danielprint/Inkjet/RepRapPiezoInkjet/Documentation/Images/HeatedSetup.JPG

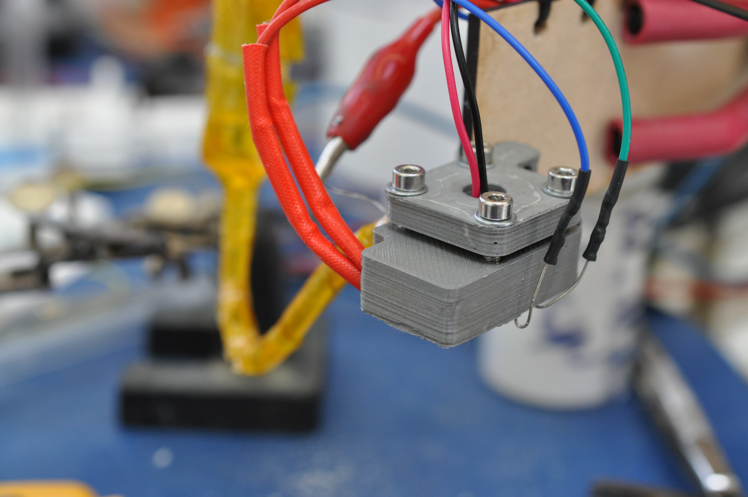
RepRapPiezoInkjet/Documentation/Images/HeatedSetup.JPG
