danielprint/Inkjet/RepRapPiezoInkjet/Documentation/Images/Assembly/DSC_4384.JPG

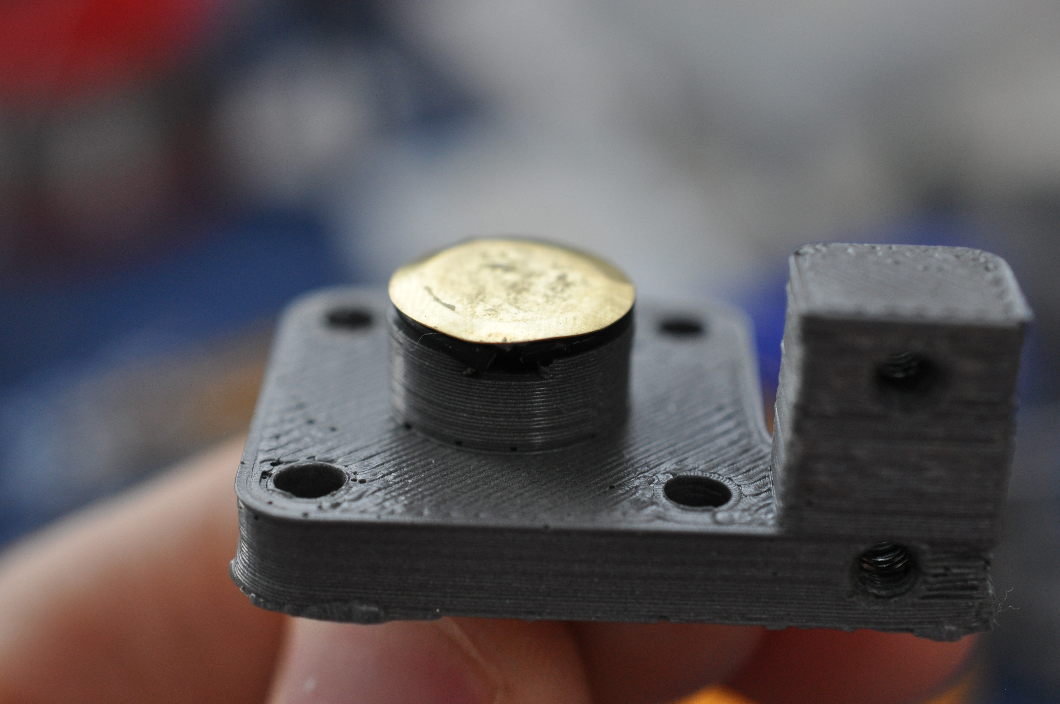
RepRapPiezoInkjet/Documentation/Images/Assembly/DSC_4384.JPG
