danielprint/Inkjet/AB-design/inkjet.png

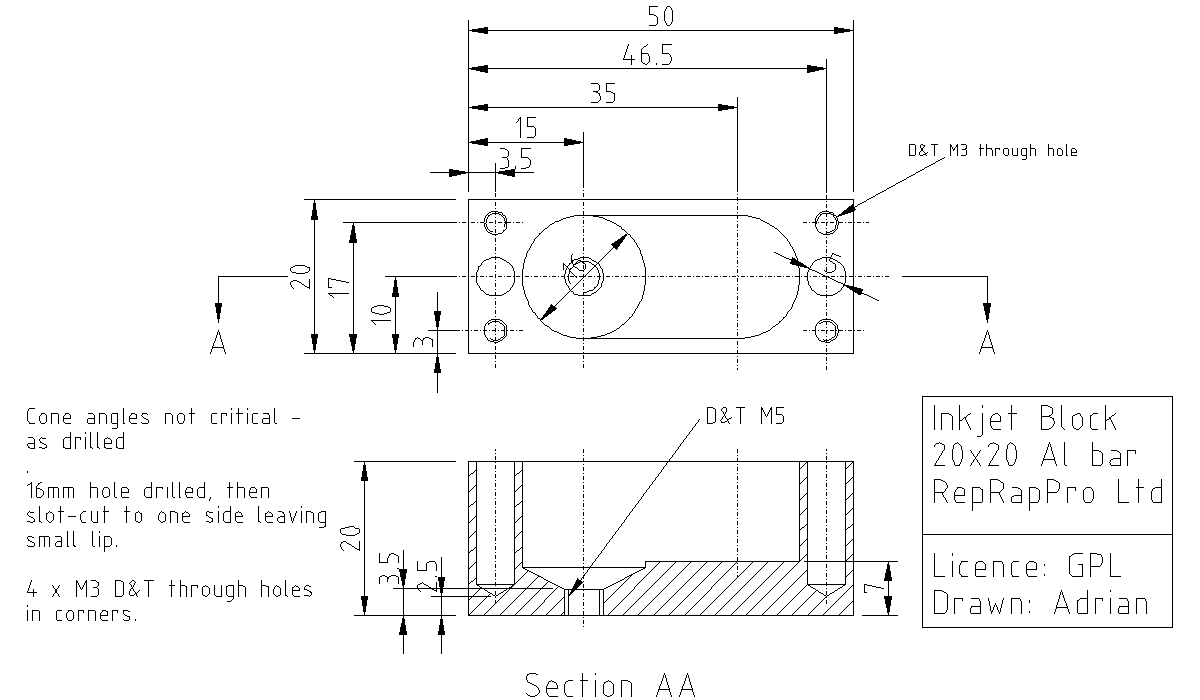
AB-design/inkjet.png
