danielprint/Inkjet/HP51604_Inkjet/Documentation/InkjetPinNumbering.png

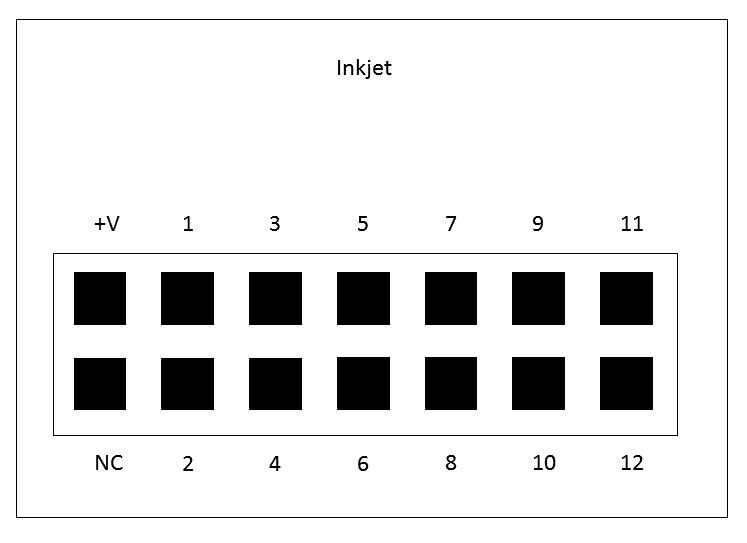
HP51604_Inkjet/Documentation/InkjetPinNumbering.png
