danielprint/Inkjet/HP51604A/InkjetHolder/section.png

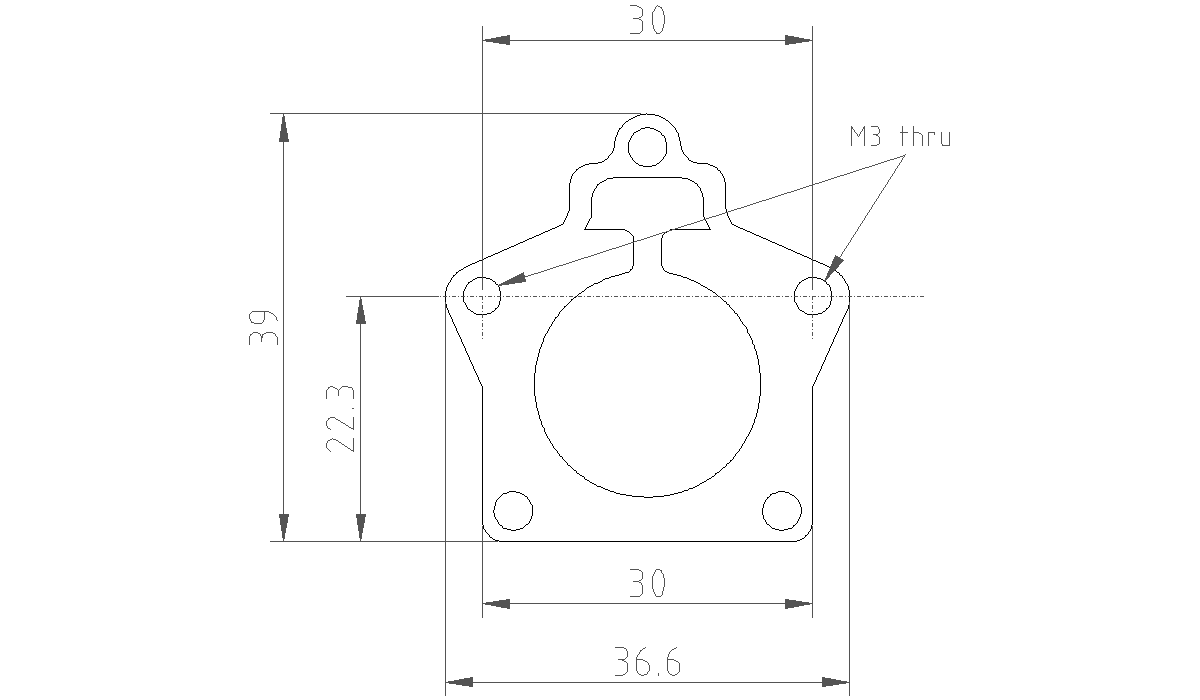
HP51604A/InkjetHolder/section.png
