danielprint/Inkjet/RepRapPiezoInkjet/Documentation/Images/JetCloseup.JPG

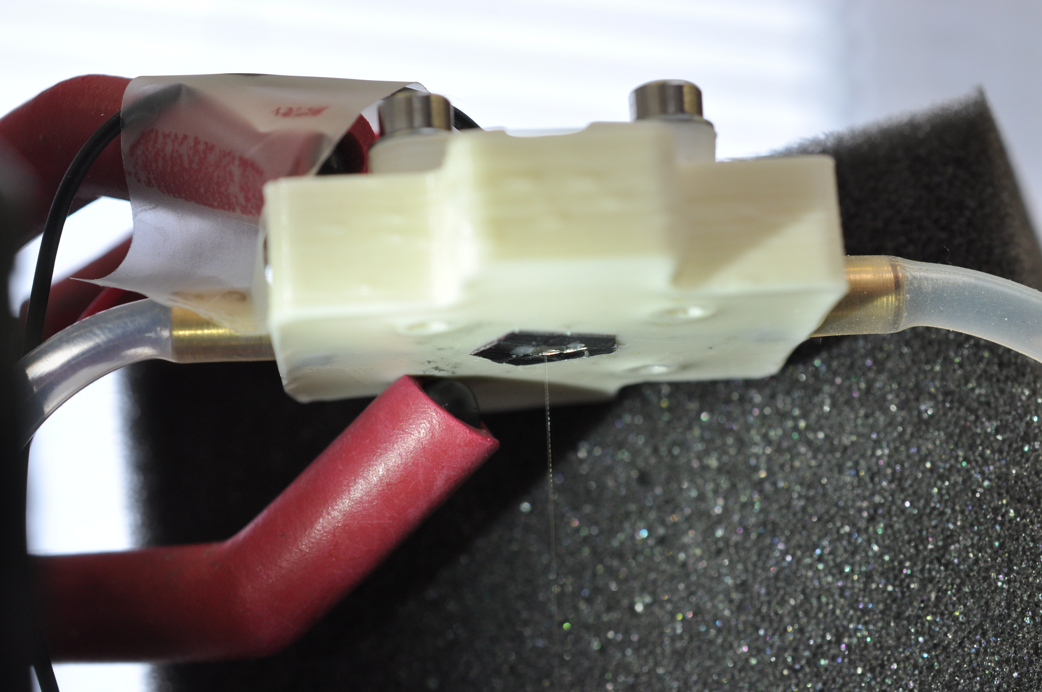
RepRapPiezoInkjet/Documentation/Images/JetCloseup.JPG
