danielprint/Inkjet/RepRapPiezoInkjet/Documentation/Images/MeshLaserCut.JPG

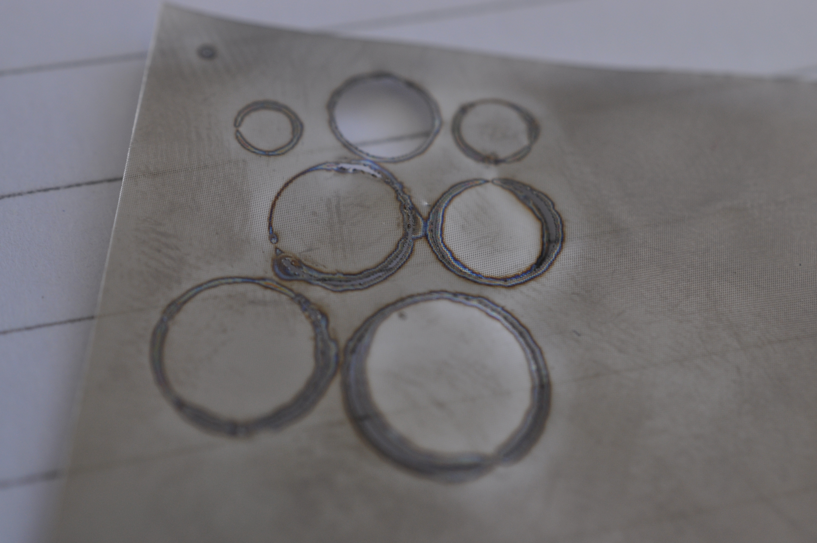
RepRapPiezoInkjet/Documentation/Images/MeshLaserCut.JPG
