danielprint/Inkjet/RepRapPiezoInkjet/Documentation/Images/MountedOnMachine.JPG

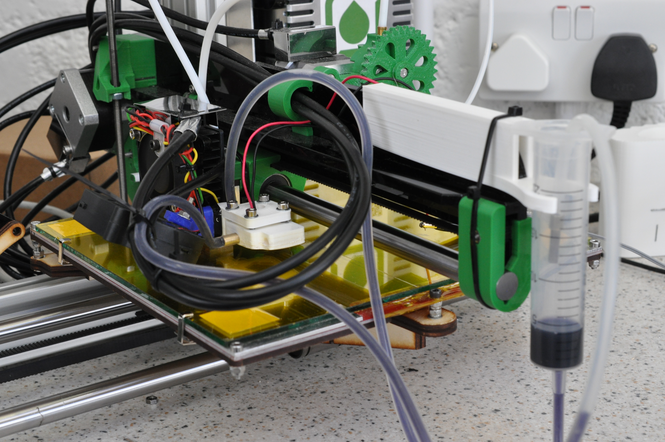
RepRapPiezoInkjet/Documentation/Images/MountedOnMachine.JPG
