danielprint/Inkjet/RepRapPiezoInkjet/Documentation/Images/NozzleCloseUp.JPG

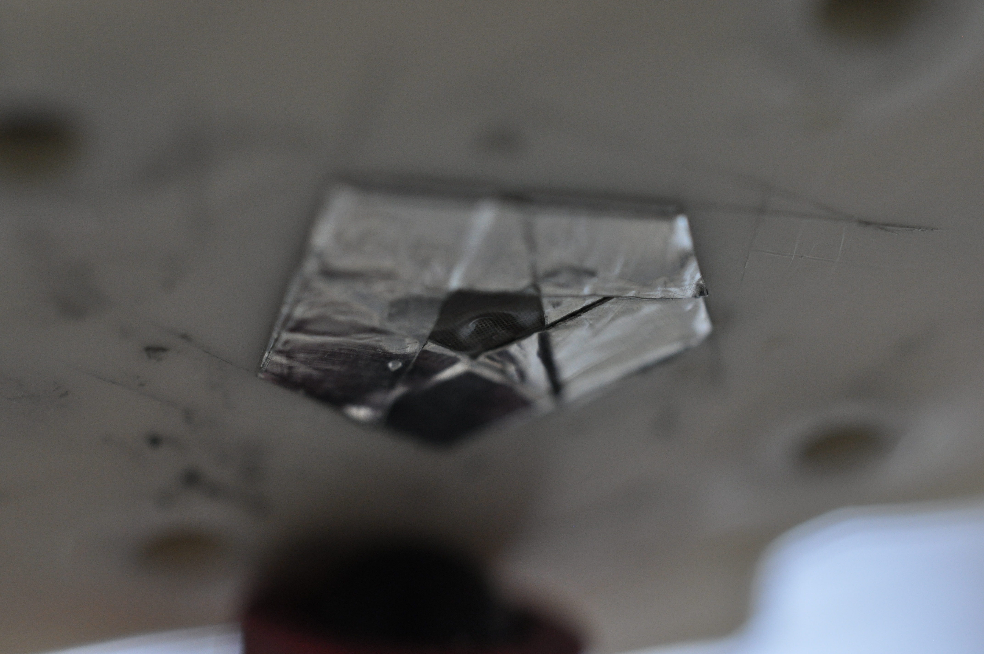
RepRapPiezoInkjet/Documentation/Images/NozzleCloseUp.JPG
