danielprint/Inkjet/HP51604_Inkjet/Documentation/BOM_mount+PCB.ods

Part Name | Qty | Type
Mount – Lower – Generic Mount | 1 | Printed Part
Mount – Upper – Generic Mount | 1 | Printed Part
Cable Tidy | 1 | Printed Part
Breakout Circuit Board | 1 | Circuit Board – Assembled
M3x12 Cap Head Machine Screw | 1 | Fastener
M3x20 Cap Head Machine Screw | 2 | Fastener
HP51604A Inkjet Cartridge | 1 | Ink cartridge
