danielprint/Inkjet/AB-design/FreeCAD/InkjetHolderHorizontalMount.fcstd

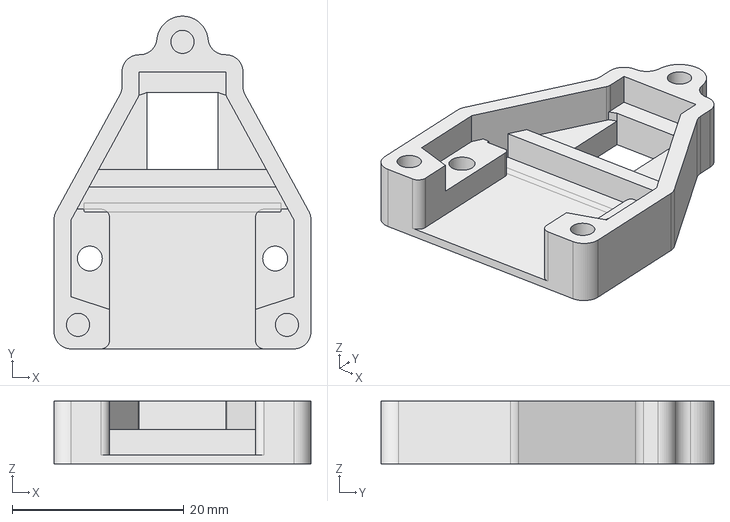
[picture p15: CAD file, 2015-09-08]
AB-design/FreeCAD/InkjetHolderHorizontalMount.fcstd
29.9 x 38.8 x 7.30 mm
