danielprint/Inkjet/AB-design/insert.stl

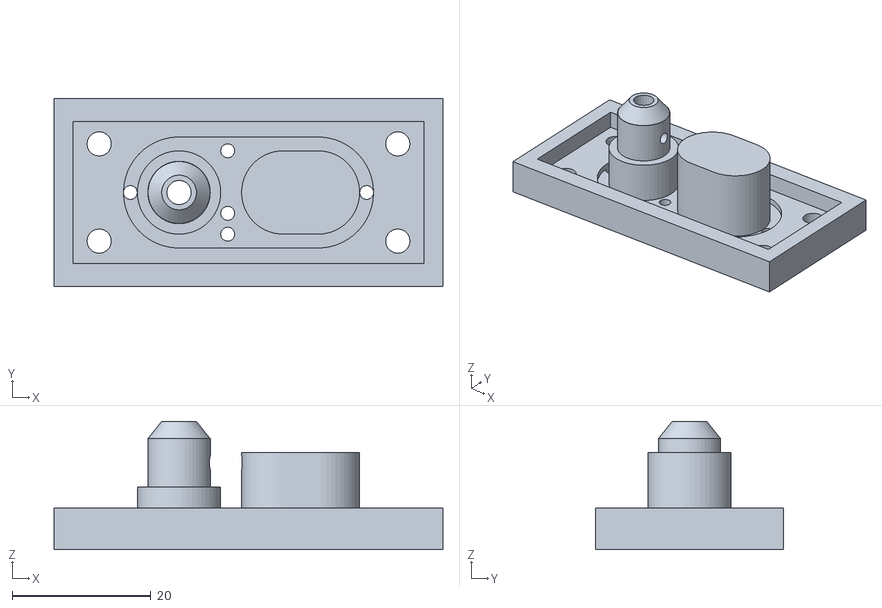
[picture p16: CAD file, 2015-09-04]
AB-design/insert.stl
56.0 x 27.0 x 18.4
