danielprint/Inkjet/HP51604_Inkjet/CircuitBoards/InkjetBreakoutPCB/InkjetBreakout-F_Cu.dxf

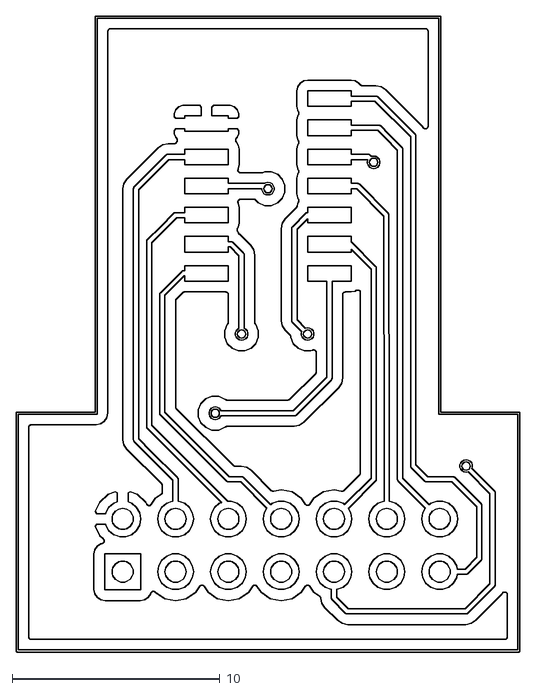
[picture p17: CAD file, 2015-09-04]
HP51604_Inkjet/CircuitBoards/InkjetBreakoutPCB/InkjetBreakout-F_Cu.dxf
24.2 x 30.6
