danielprint/Inkjet/HP51604_Inkjet/CircuitBoards/InkjetDriverPCB/Gerbers/InkjetDriver-F_Cu.dxf

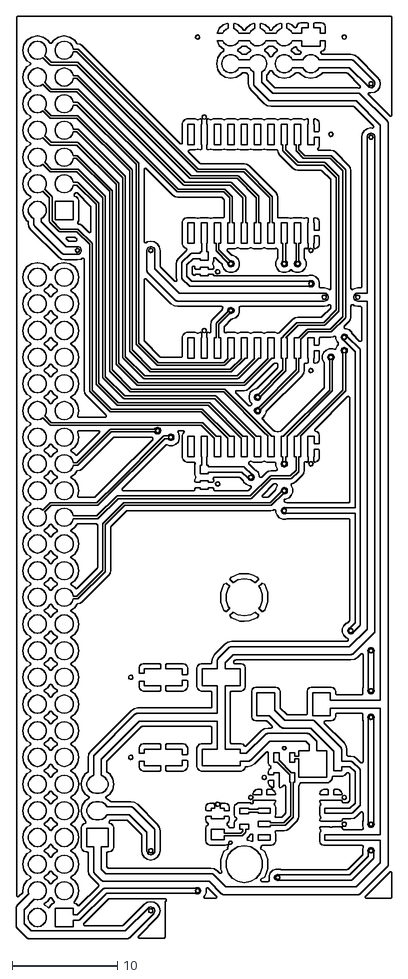
[picture p18: CAD file, 2015-09-04]
HP51604_Inkjet/CircuitBoards/InkjetDriverPCB/Gerbers/InkjetDriver-F_Cu.dxf
35.8 x 87.8
