danielprint/Inkjet/HP51604_Inkjet/Printed_Parts/CartridgeOnlyKit/STEP/UpperHorizontalMount.stp

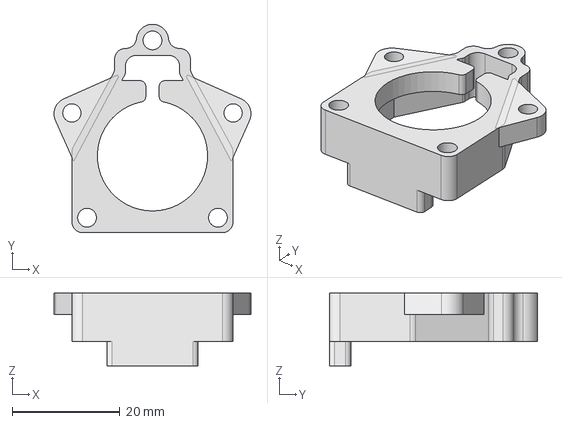
[picture p19: CAD file, 2015-09-04]
HP51604_Inkjet/Printed_Parts/CartridgeOnlyKit/STEP/UpperHorizontalMount.stp
36.6 x 38.8 x 13.5 mm
