danielprint/Inkjet/HP51604_Inkjet/Printed_Parts/FullOrmerodKit/STEP/UpperOrmerodMount.stp

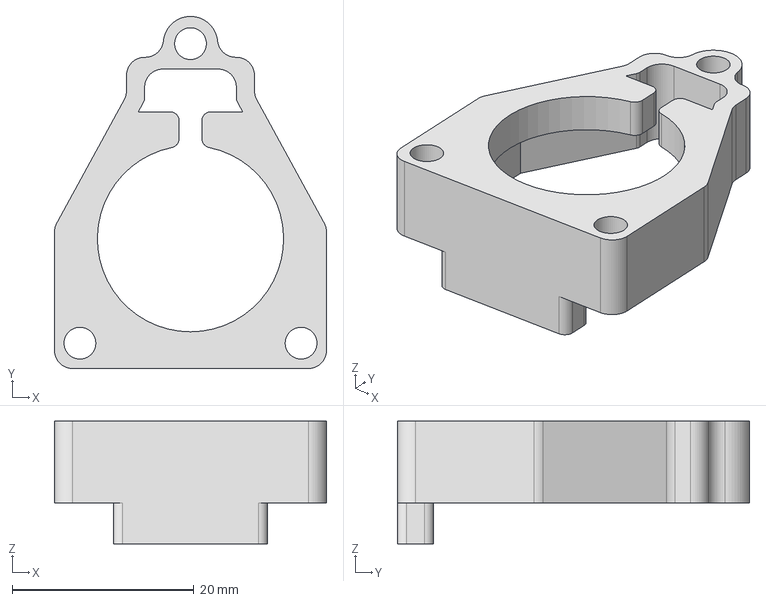
[picture p20: CAD file, 2015-09-04]
HP51604_Inkjet/Printed_Parts/FullOrmerodKit/STEP/UpperOrmerodMount.stp
29.9 x 38.8 x 13.5 mm
