danielprint/Inkjet/HP51604A/InkjetHolder/section.dxf

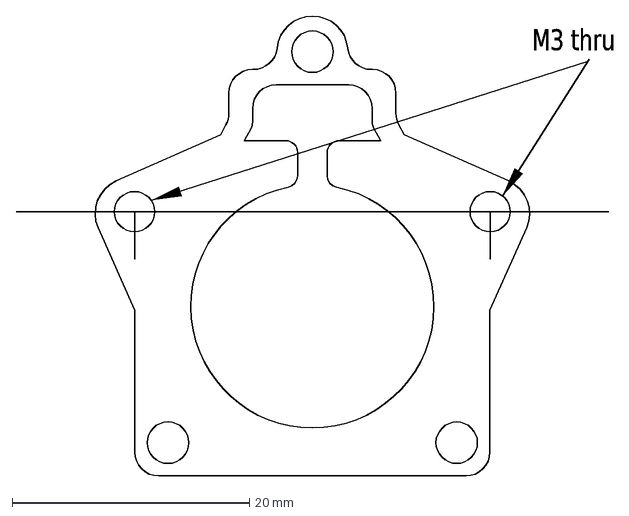
[picture p21: CAD file, 2015-09-08]
HP51604A/InkjetHolder/section.dxf
M3 thru
