danielprint/Inkjet/HP51604A/outline.dxf

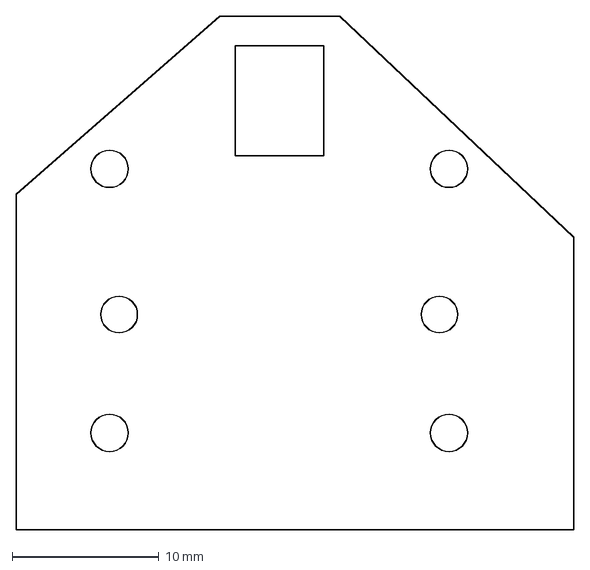
[picture p22: CAD file, 2014-11-24]
HP51604A/outline.dxf
38.0 x 35.0 mm
