danielprint/Inkjet/RepRapPiezoInkjet/12mmInkjet/STEP/Body.stp

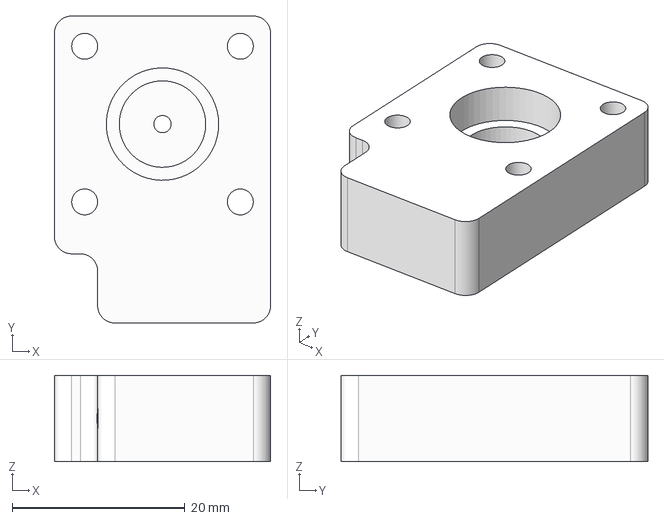
[picture p23: CAD file, 2015-09-04]
RepRapPiezoInkjet/12mmInkjet/STEP/Body.stp
25.0 x 35.5 x 10.0 mm
