danielprint/Inkjet/RepRapPiezoInkjet/12mmInkjet/STL/Top_Genertic.stl

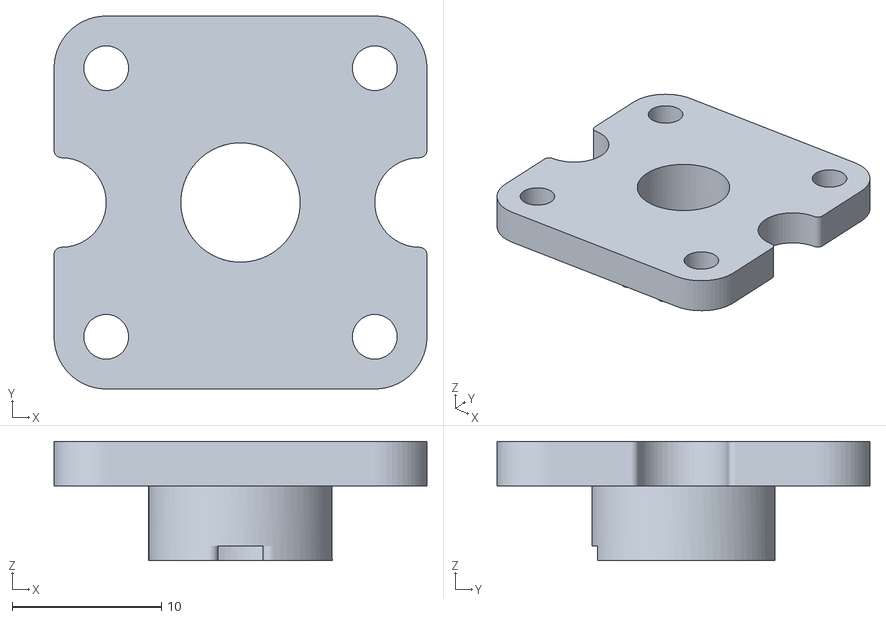
[picture p24: CAD file, 2015-09-04]
RepRapPiezoInkjet/12mmInkjet/STL/Top_Genertic.stl
25.0 x 25.0 x 8.00
