danielprint/Inkjet/AB-design/inkjet.dxf

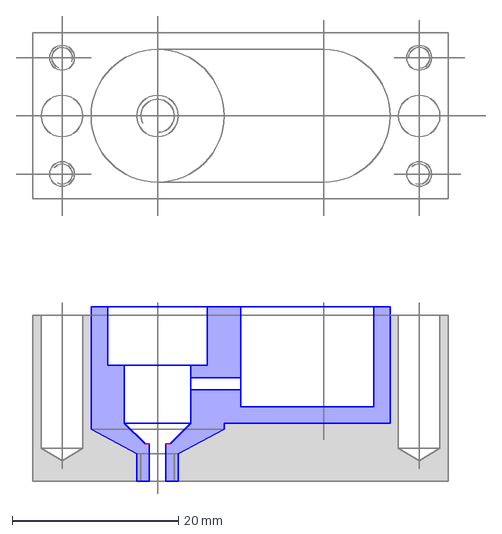
[picture p25: CAD file, 2015-09-04]
AB-design/inkjet.dxf
56.5 x 57.5 mm
