danielprint/Inkjet/HP51604_Inkjet/Printed_Parts/CartridgeOnlyKit/STEP/CableTidy.stp

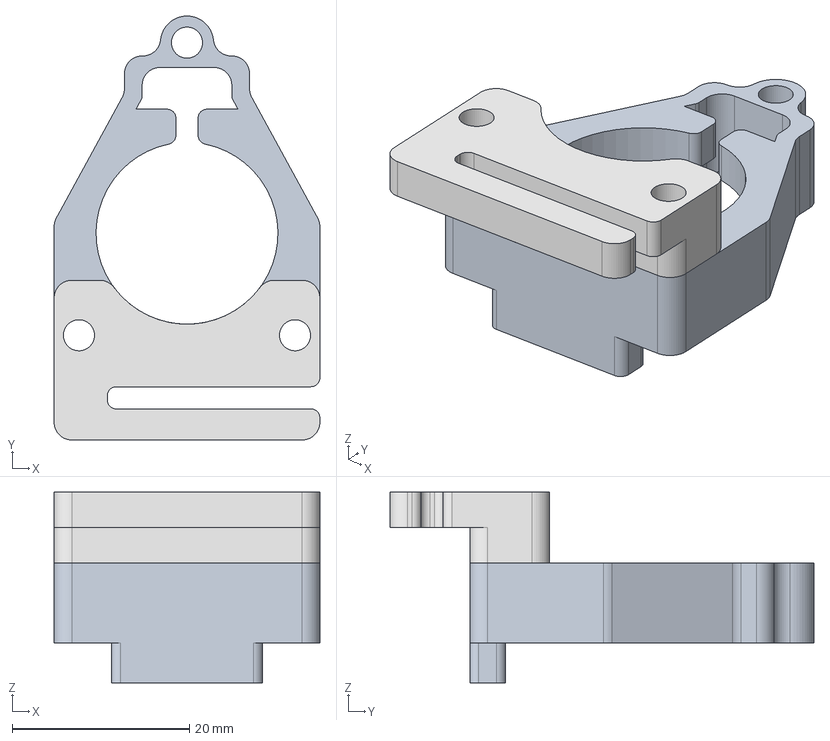
[picture p26: CAD file, 2015-09-04]
HP51604_Inkjet/Printed_Parts/CartridgeOnlyKit/STEP/CableTidy.stp
29.9 x 47.8 x 21.5 mm
