danielprint/Inkjet/HP51604_Inkjet/Printed_Parts/FullOrmerodKit/STEP/BottomOrmerodMount.stp

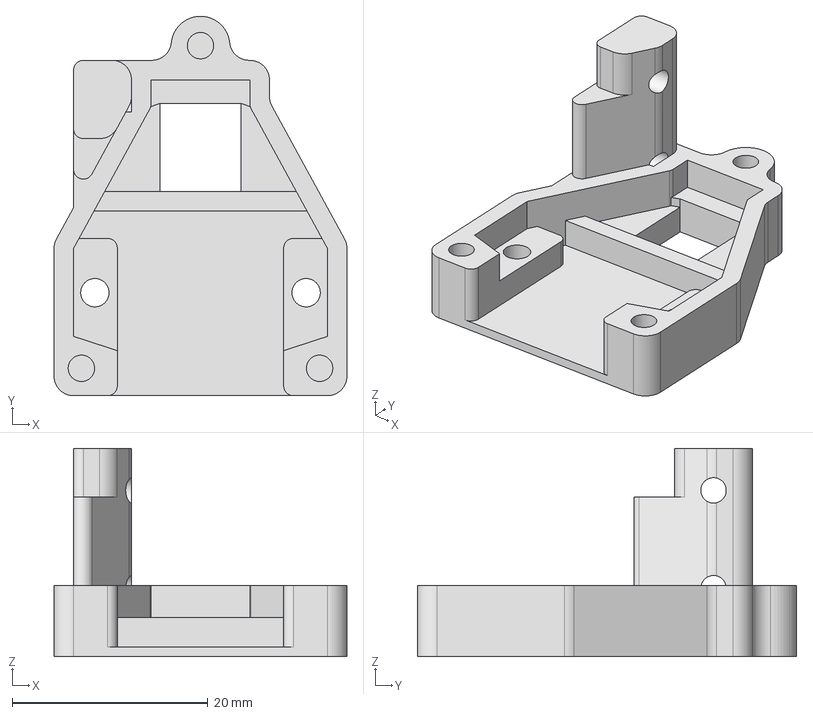
[picture p27: CAD file, 2015-09-04]
HP51604_Inkjet/Printed_Parts/FullOrmerodKit/STEP/BottomOrmerodMount.stp
29.9 x 38.8 x 21.3 mm
