danielprint/Inkjet/HP51604A/chans-outline.dxf

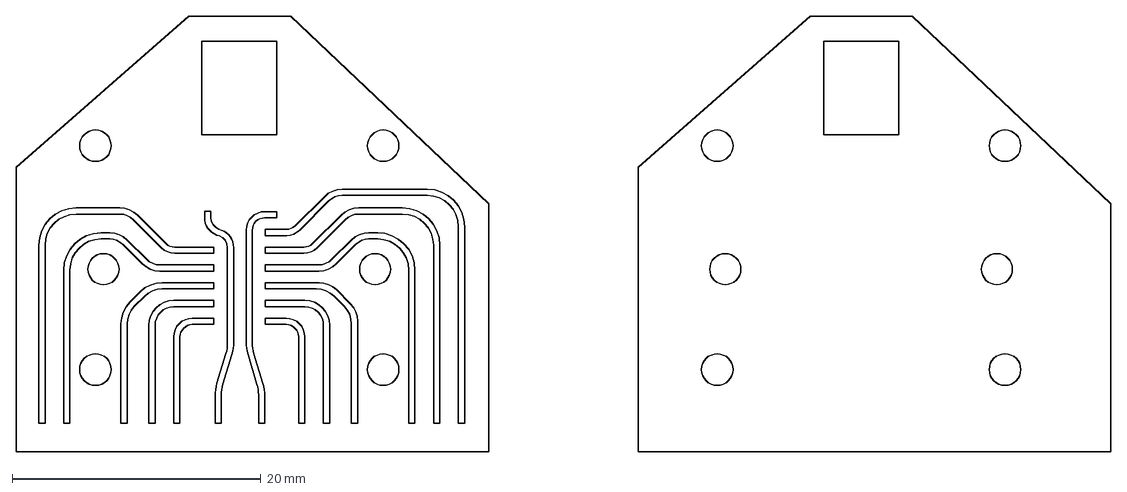
[picture p28: CAD file, 2014-11-24]
HP51604A/chans-outline.dxf
88.0 x 35.0 mm
