danielprint/Inkjet/RepRapPiezoInkjet/12mmInkjet/STEP/Top_OrmerodMount.stp

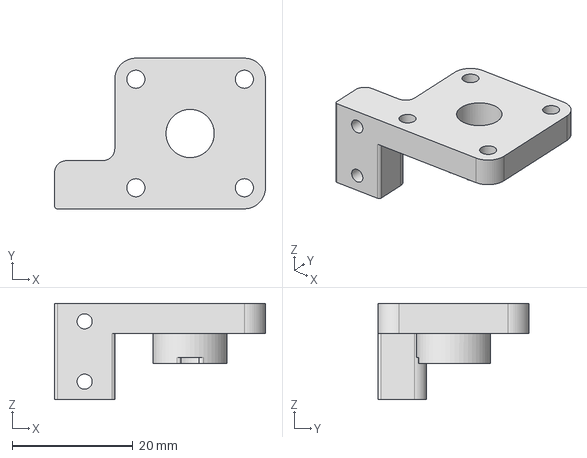
[picture p29: CAD file, 2015-09-04]
RepRapPiezoInkjet/12mmInkjet/STEP/Top_OrmerodMount.stp
35.0 x 25.0 x 16.0 mm
