danielprint/Inkjet/HP51604A/slots.dxf

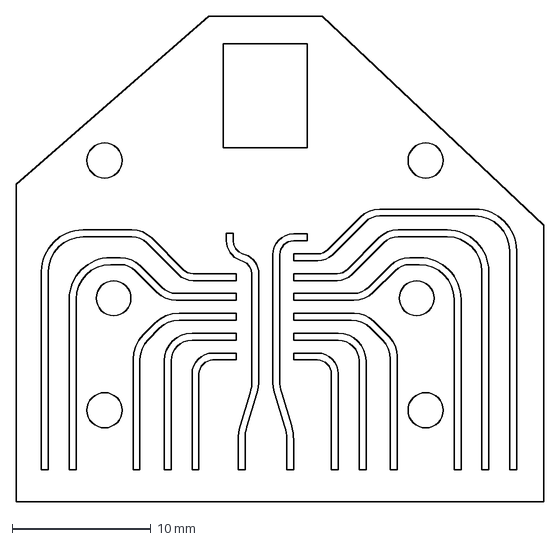
[picture p30: CAD file, 2014-11-24]
HP51604A/slots.dxf
38.0 x 35.0 mm
