danielprint/Inkjet/RepRapPiezoInkjet/12mmInkjet/STEP/SyringeReservoirOrmerodMount.stp

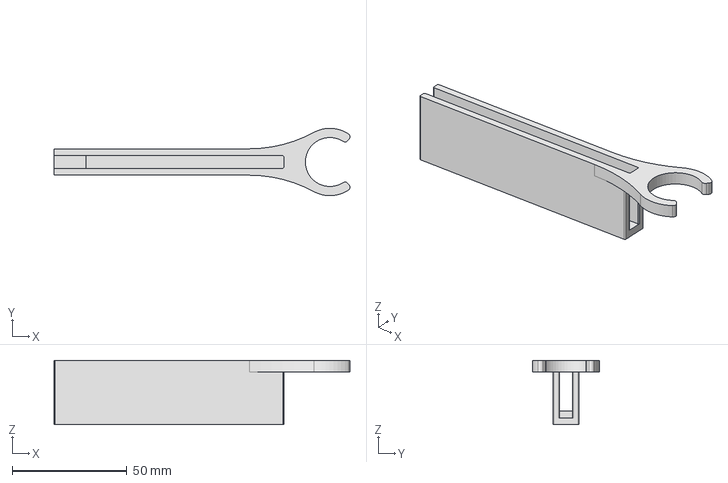
[picture p31: CAD file, 2015-09-04]
RepRapPiezoInkjet/12mmInkjet/STEP/SyringeReservoirOrmerodMount.stp
128.7 x 29.3 x 28.0 mm
