danielprint/Inkjet/HP51604A/test.dxf

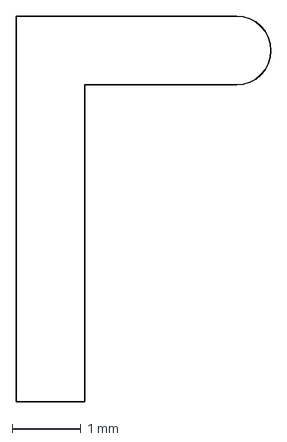
[picture p32: CAD file, 2014-09-24]
HP51604A/test.dxf
3.70 x 5.60 mm
