danielprint/Inkjet/HP51604A/just-slots.dxf

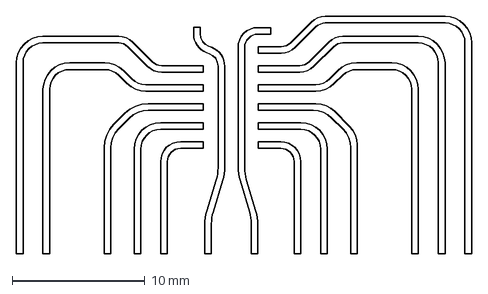
[picture p33: CAD file, 2014-09-24]
HP51604A/just-slots.dxf
34.2 x 17.9 mm
