danielprint/Inkjet/(list of files, cad)

Other CAD files:
HP51604_Inkjet/Other/HP51604A/InkjetHolder/InkjetHolderHorizontalMount.stp
AB-design/FreeCAD/UpperHorizontalMount.fcstd
HP51604_Inkjet/Other/HP51604A/InkjetHolder/InkjetHolderVerticalMount.stp
HP51604_Inkjet/Printed_Parts/CartridgeOnlyKit/STEP/InkjetHolderHorizontalMount.stp
HP51604_Inkjet/Other/HP51604A/InkjetHolder/UpperVerticalMount.stp
RepRapPiezoInkjet/12mmInkjet/STEP/Top_Generic.stp
HP51604_Inkjet/Other/HP51604A/InkjetHolder/CableTidy.stp
HP51604A/HP51604A.fcstd
HP51604_Inkjet/Other/HP51604A/InkjetHolder/CableTidy.stl
HP51604_Inkjet/Other/HP51604A/InkjetHolder/InkjetHolderHorizontalMount.fcstd
HP51604_Inkjet/Other/HP51604A/InkjetHolder/InkjetHolderHorizontalMount.stl
HP51604_Inkjet/Other/HP51604A/InkjetHolder/InkjetHolderVerticalMount.stl
HP51604_Inkjet/Other/HP51604A/InkjetHolder/UpperHorizontalMount.fcstd
HP51604_Inkjet/Other/HP51604A/InkjetHolder/UpperHorizontalMount.stl
HP51604_Inkjet/Other/HP51604A/InkjetHolder/UpperVerticalMount.stl
HP51604_Inkjet/Printed_Parts/CartridgeOnlyKit/STL/CableTidy.stl
HP51604_Inkjet/Printed_Parts/CartridgeOnlyKit/STL/InkjetHolderHorizontalMount.stl
HP51604_Inkjet/Printed_Parts/CartridgeOnlyKit/STL/UpperHorizontalMount.stl
HP51604_Inkjet/Printed_Parts/FullOrmerodKit/STL/BottomOrmerodMount.stl
HP51604_Inkjet/Printed_Parts/FullOrmerodKit/STL/CableTidy.stl
HP51604_Inkjet/Printed_Parts/FullOrmerodKit/STL/UpperOrmerodMount.stl
RepRapPiezoInkjet/12mmInkjet/STL/Body.stl
RepRapPiezoInkjet/12mmInkjet/STL/SyringeReservoirOrmerodMount.stl
RepRapPiezoInkjet/12mmInkjet/STL/Top_OrmerodMount.stl
