danielprint/Inkjet/RepRapPiezoInkjet/Documentation/Images/Assembly/DSC_4382.JPG

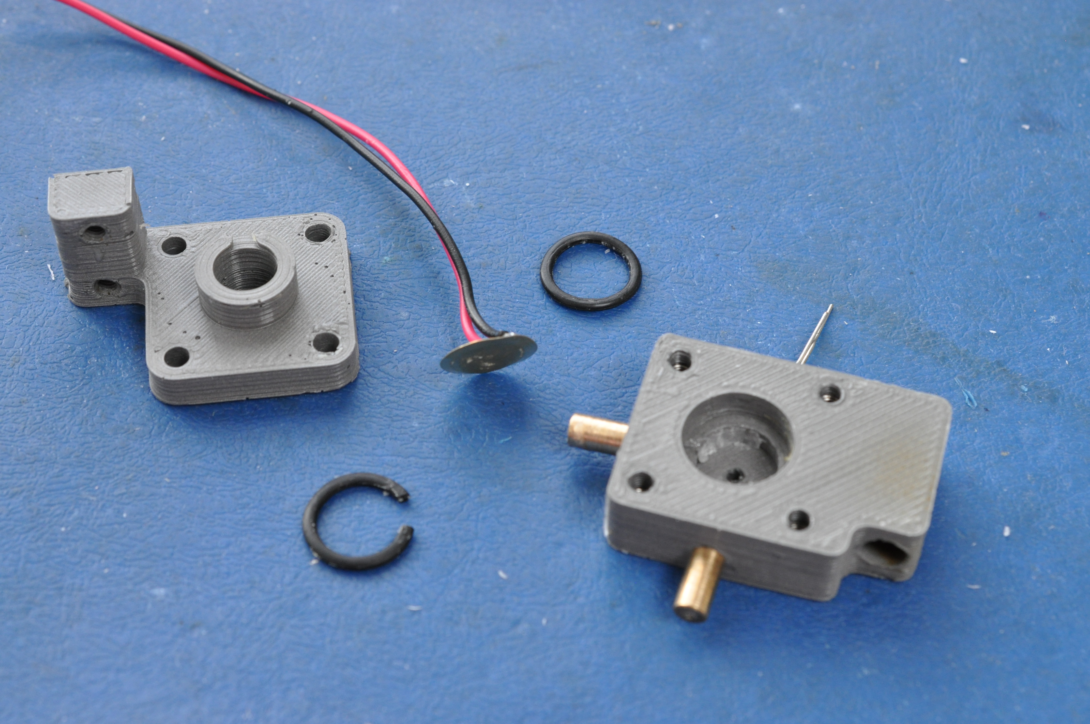
RepRapPiezoInkjet/Documentation/Images/Assembly/DSC_4382.JPG
