danielprint/Inkjet/RepRapPiezoInkjet/Documentation/Images/Assembly/DSC_4383.JPG

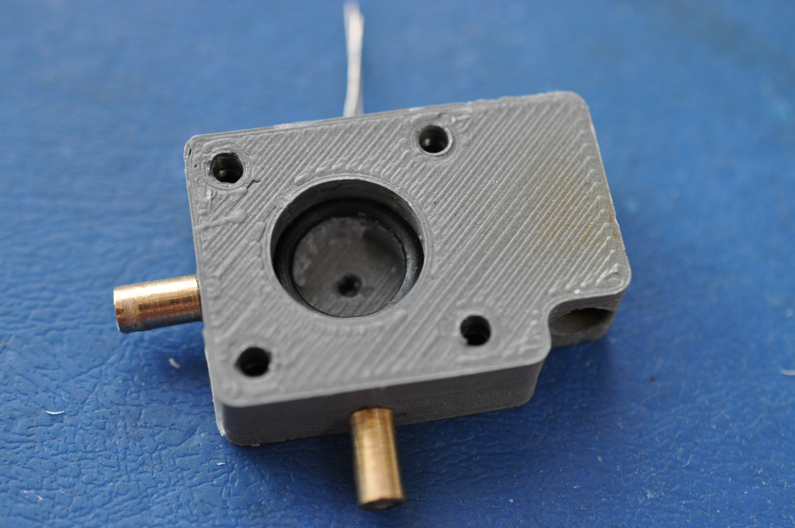
RepRapPiezoInkjet/Documentation/Images/Assembly/DSC_4383.JPG
