danielprint/Inkjet/RepRapPiezoInkjet/Documentation/Images/Assembly/DSC_4385.JPG

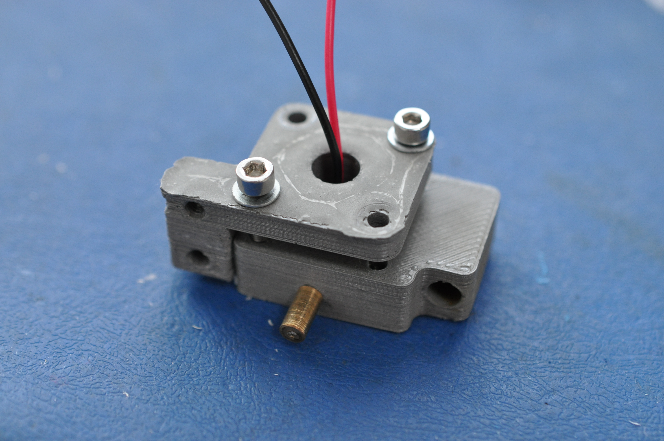
RepRapPiezoInkjet/Documentation/Images/Assembly/DSC_4385.JPG
