danielprint/Inkjet/RepRapPiezoInkjet/Documentation/Images/Assembly/DSC_4386.JPG

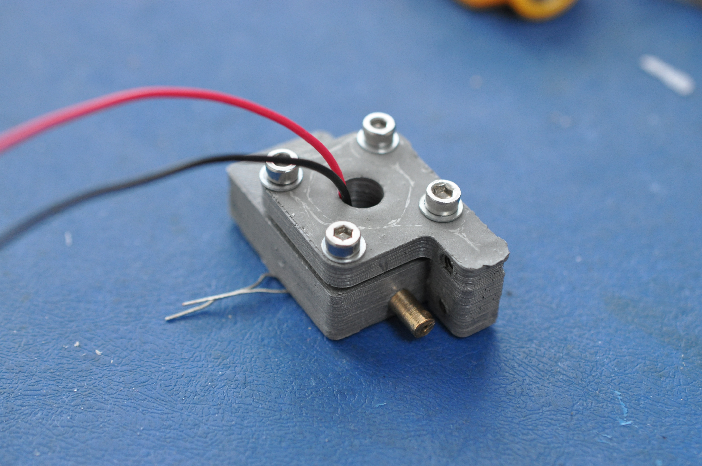
RepRapPiezoInkjet/Documentation/Images/Assembly/DSC_4386.JPG
