danielprint/Inkjet/RepRapPiezoInkjet/Documentation/Images/Assembly/DSC_4391.JPG

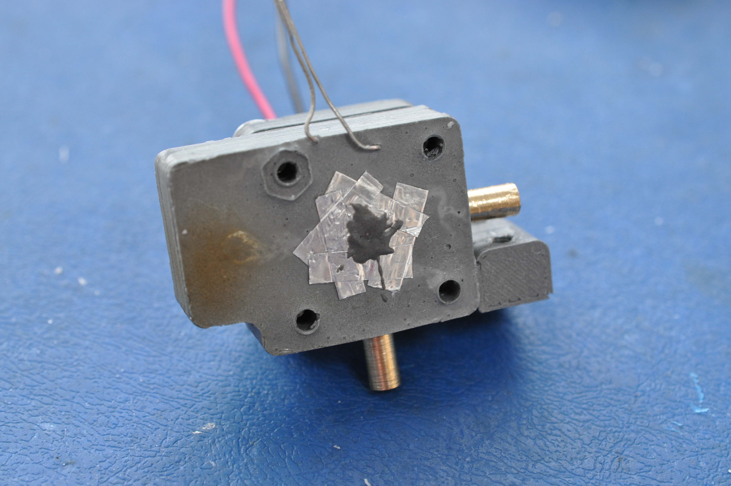
RepRapPiezoInkjet/Documentation/Images/Assembly/DSC_4391.JPG
