danielprint/Inkjet/RepRapPiezoInkjet/Documentation/Images/Assembly/DSC_4396.JPG

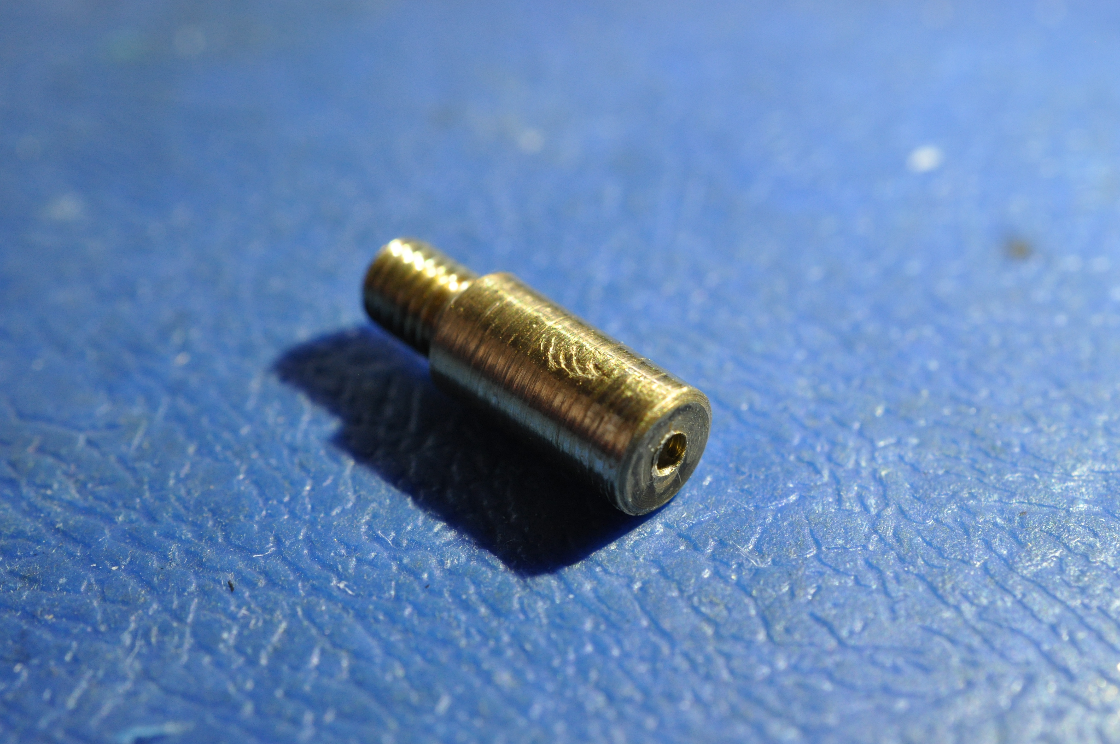
RepRapPiezoInkjet/Documentation/Images/Assembly/DSC_4396.JPG
