danielprint/Inkjet/RepRapPiezoInkjet/Documentation/Images/Assembly/DSC_4397.JPG

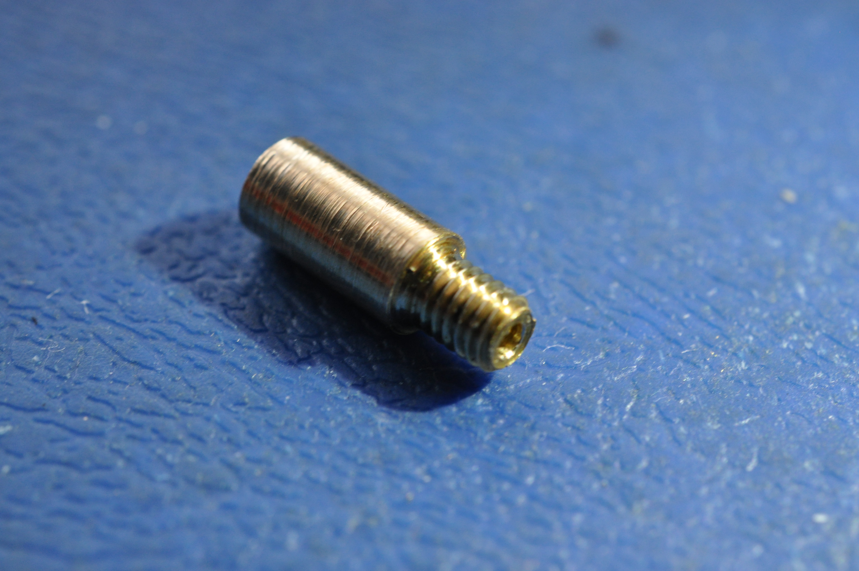
RepRapPiezoInkjet/Documentation/Images/Assembly/DSC_4397.JPG
