danielprint/Inkjet/RepRapPiezoInkjet/Documentation/Images/GeneralSetup.JPG

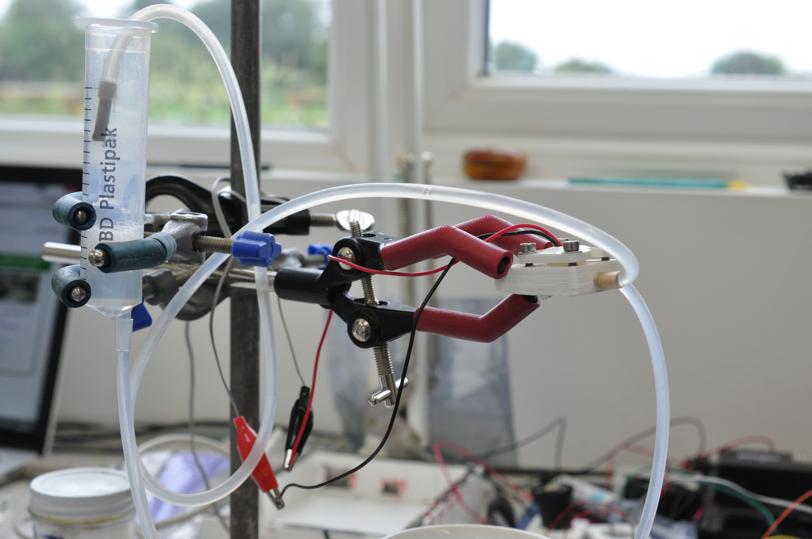
RepRapPiezoInkjet/Documentation/Images/GeneralSetup.JPG
