danielprint/Inkjet/RepRapPiezoInkjet/Documentation/Images/PrintedInkjetBottom.JPG

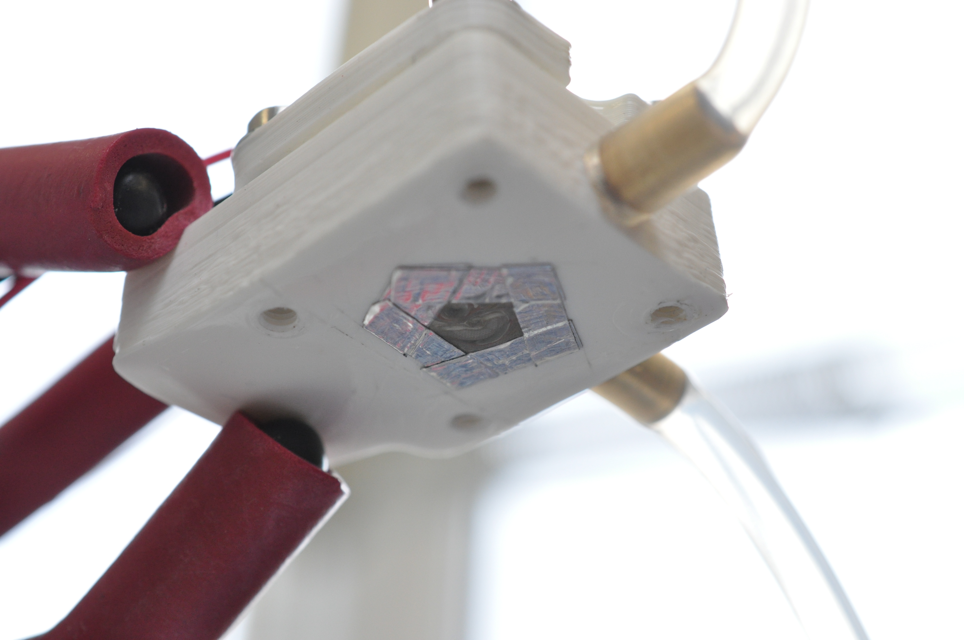
RepRapPiezoInkjet/Documentation/Images/PrintedInkjetBottom.JPG
