danielprint/Inkjet/RepRapPiezoInkjet/Documentation/Images/PrintedInkjetCloseup.JPG

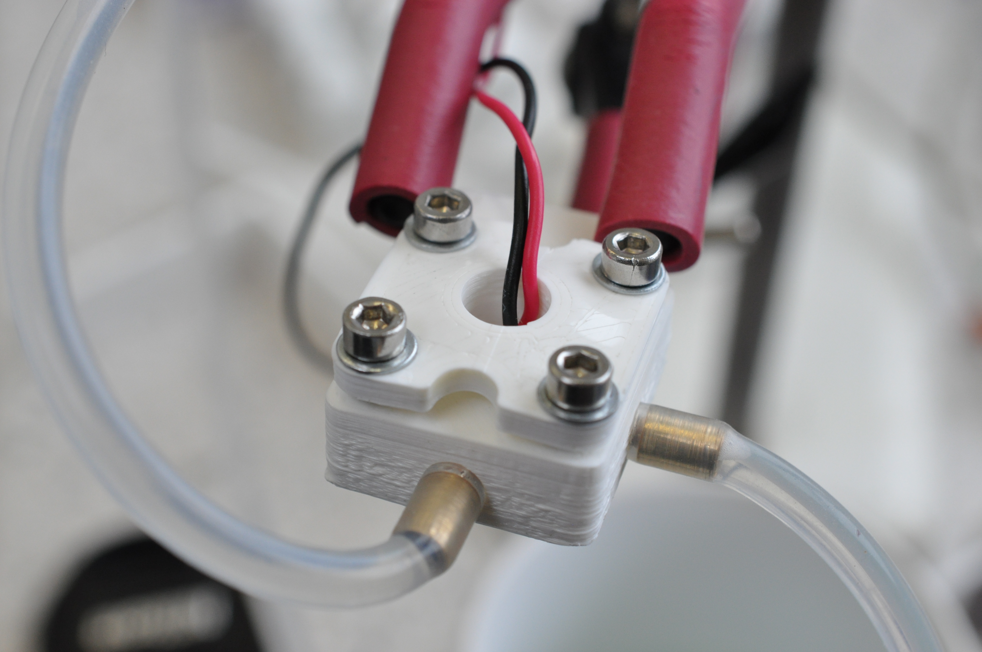
RepRapPiezoInkjet/Documentation/Images/PrintedInkjetCloseup.JPG
