danielprint/Inkjet/HP51604_Inkjet/CircuitBoards/InkjetDriverPCB/InkjetDriver.pdf

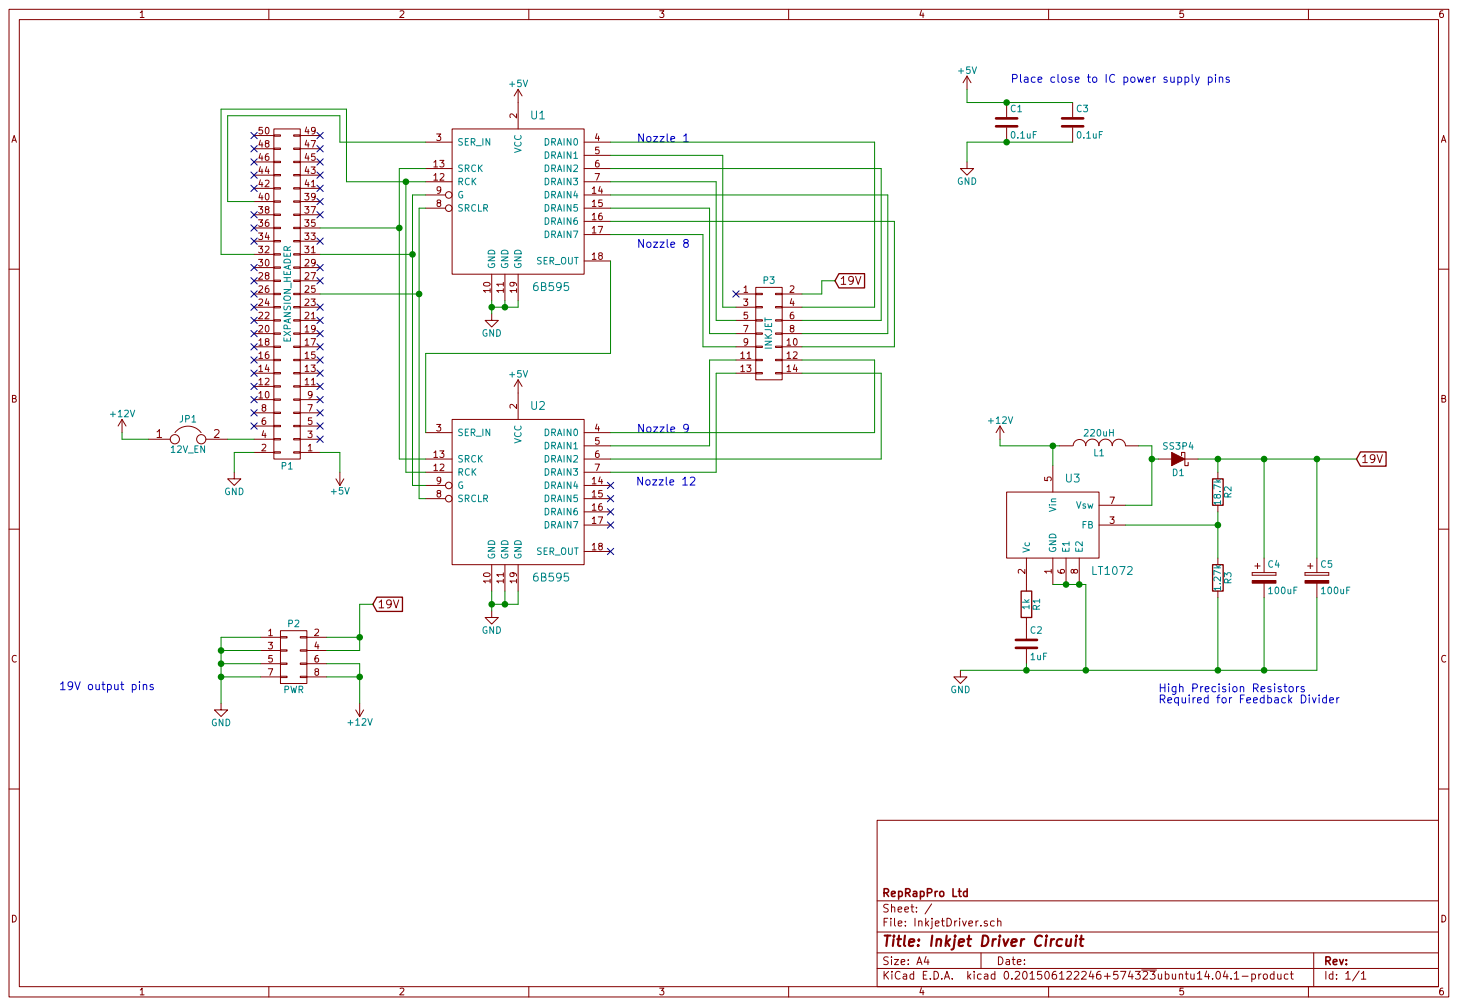
[picture p46: page 1]

File: InkjetDriver.sch Sheet: / RepRapPro Ltd VCC

7 3 | 8 P2 PWR 4

Required for Feedback Divider

Id: 1/1 Title: Inkjet Driver Circuit
