danielprint/Inkjet/HP51604_Inkjet/CircuitBoards/InkjetBreakoutPCB/InkjetBreakout.pdf

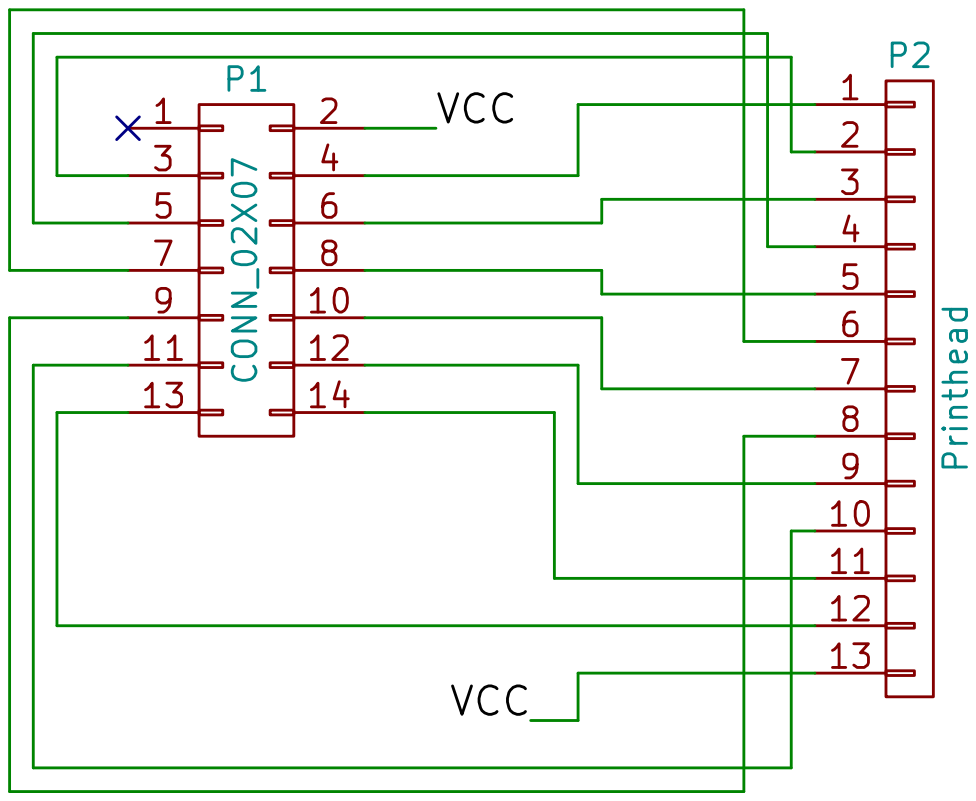
[picture p47: page 1]

10

File: InkjetBreakout.sch Sheet: /
Id: 1/1 Title:
