danielprint/Inkjet/HP51604_Inkjet/CircuitBoards/InkjetBreakoutPCB/Gerbers/InkjetBreakout-B_Cu.pdf

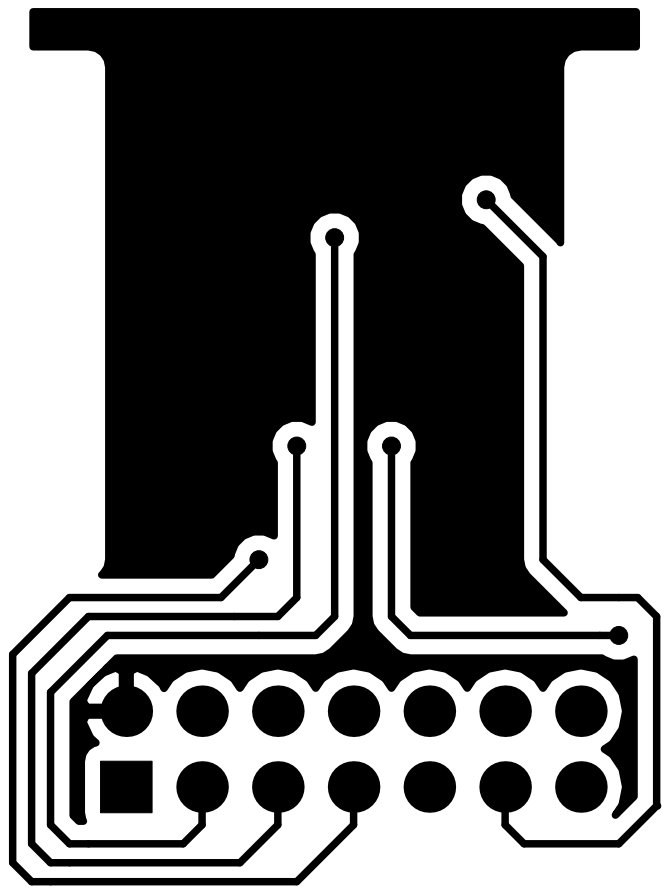
[picture p48: page 1]
