danielprint/Inkjet/HP51604_Inkjet/CircuitBoards/InkjetBreakoutPCB/Gerbers/InkjetBreakout-F_Cu.pdf

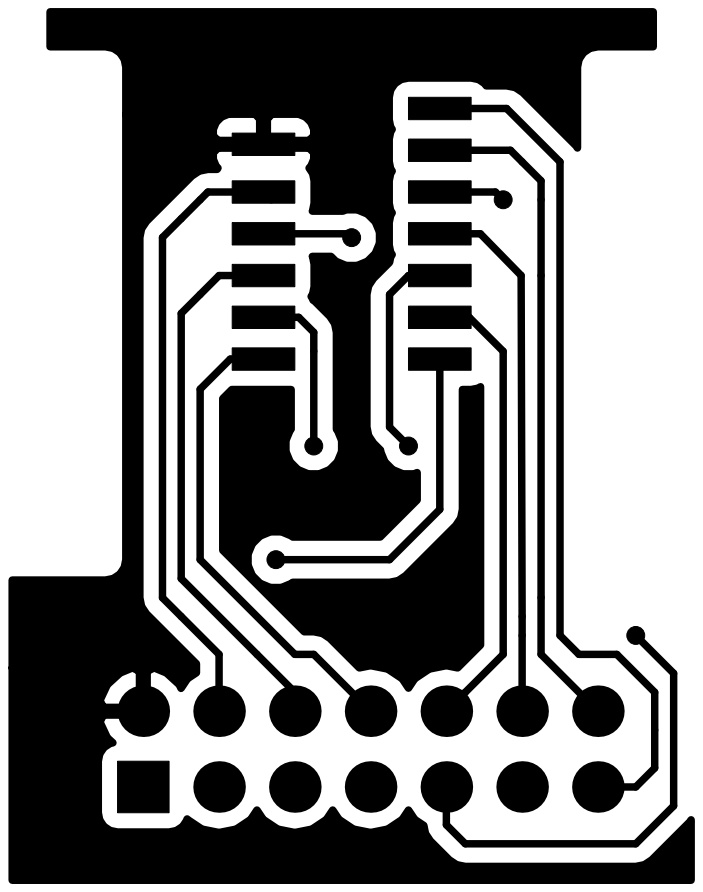
[picture p49: page 1]
