danielprint/Inkjet/HP51604_Inkjet/CircuitBoards/InkjetBreakoutPCB/Gerbers/InkjetBreakout-F_Mask.pdf

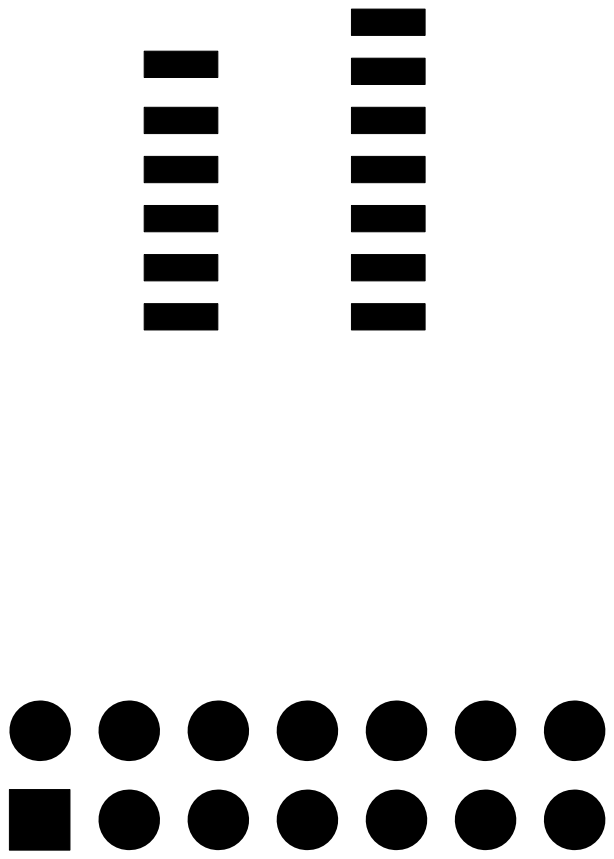
[picture p50: page 1]
