danielprint/Inkjet/HP51604_Inkjet/CircuitBoards/InkjetBreakoutPCB/Gerbers/InkjetBreakout-F_SilkS.pdf

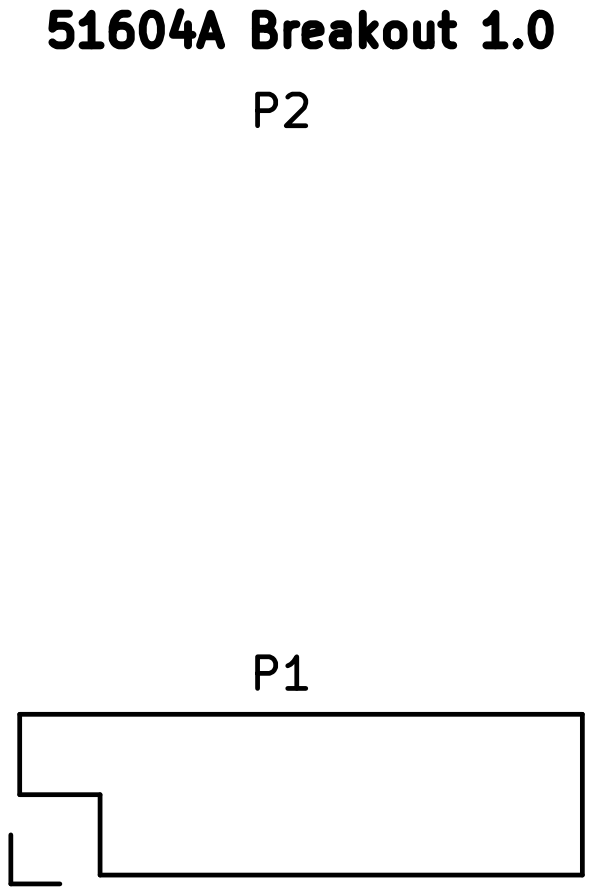
[picture p51: page 1]
