danielprint/Inkjet/RepRapPiezoInkjet/PiezoDriverPCB/PiezoDriver/PiezoDriver.kicad_pcb

## KiCad design RepRapPiezoInkjet/PiezoDriverPCB/PiezoDriver/PiezoDriver.kicad_pcb (2015-09-04)

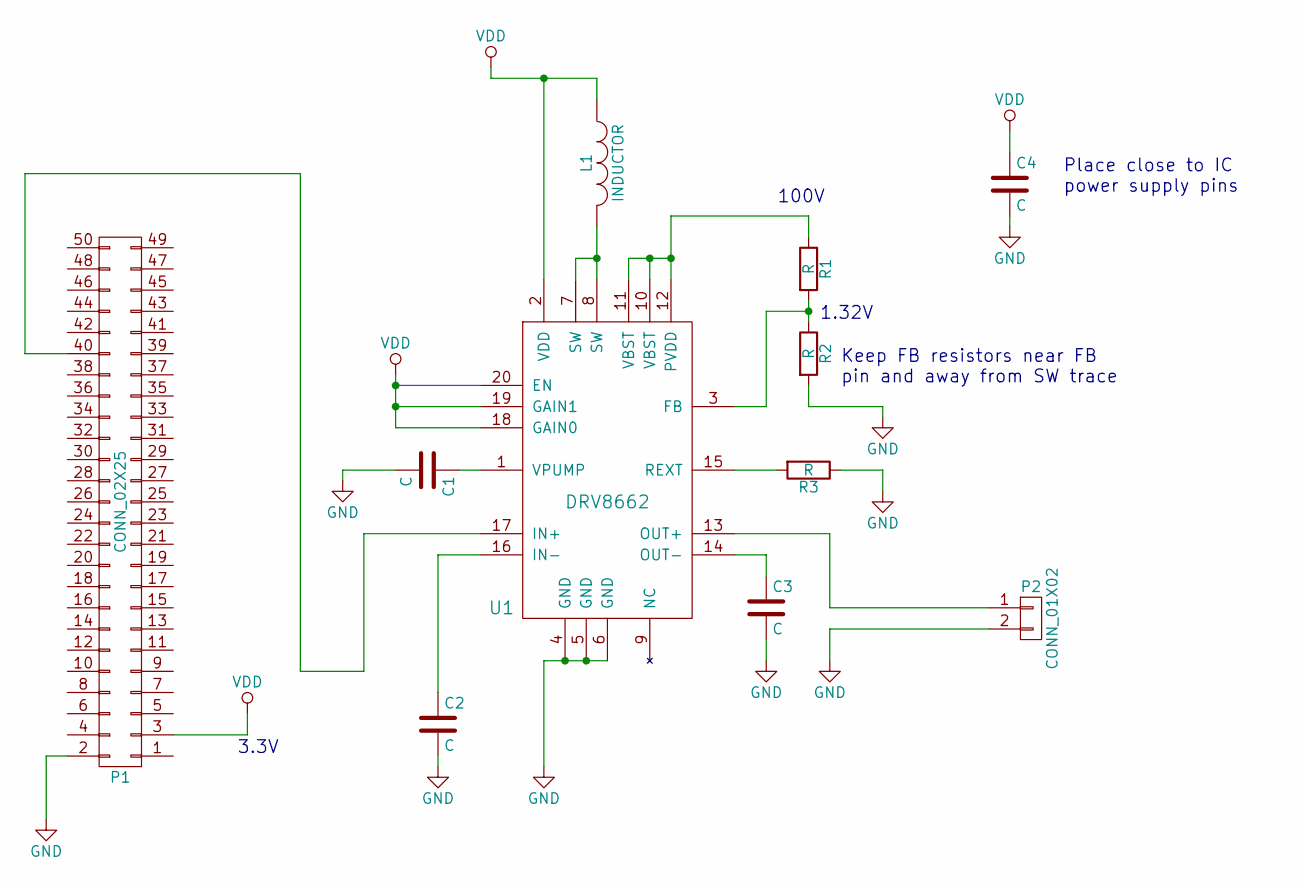
[picture p52: schematic PiezoDriver.sch]

Parts:
C1, C2, C3, C4: C; C_0805
L1: INDUCTOR; SELF-WE-TPC_M
P1: CONN_02X25; Pin_Header_Straight_2x25
P2: CONN_01X02; Pin_Header_Straight_1x02
R1, R2, R3: R; R_0603
U1: DRV8662; QFN-20-1EP_4x4mm_Pitch0.5mm

Connections:
GND: C1.2, C2.2, C3.2, C4.2, P1.2, P2.2, R2.2, R3.1, U1.4 (GND), U1.5 (GND), U1.6 (GND)
unnamed: C1.1, U1.1 (VPUMP)
unnamed: C2.1, U1.16 (IN-)
unnamed: C3.1, U1.14 (OUT-)
unnamed: L1.2, U1.7 (SW), U1.8 (SW)
unnamed: P1.40, U1.17 (IN+)
unnamed: P2.1, U1.13 (OUT+)
unnamed: R1.1, U1.10 (VBST), U1.11 (VBST), U1.12 (PVDD)
unnamed: R1.2, R2.1, U1.3 (FB)
unnamed: R3.2, U1.15 (REXT)
VDD: C4.1, L1.1, P1.3, U1.2 (VDD), U1.18 (GAIN0), U1.19 (GAIN1), U1.20 (EN)

Notes on the sheet:
Place close to IC power supply pins
3.3V
100V
1.32V
Keep FB resistors near FB pin and away from SW trace

Board: 2 copper layers, 11 parts (0 on the bottom side), 11 nets, no tracks yet.
