danielprint/Inkjet/HP51604_Inkjet/CircuitBoards/InkjetDriverPCB/InkjetDriver.kicad_pcb

## KiCad design HP51604_Inkjet/CircuitBoards/InkjetDriverPCB/InkjetDriver.kicad_pcb (2015-09-04)

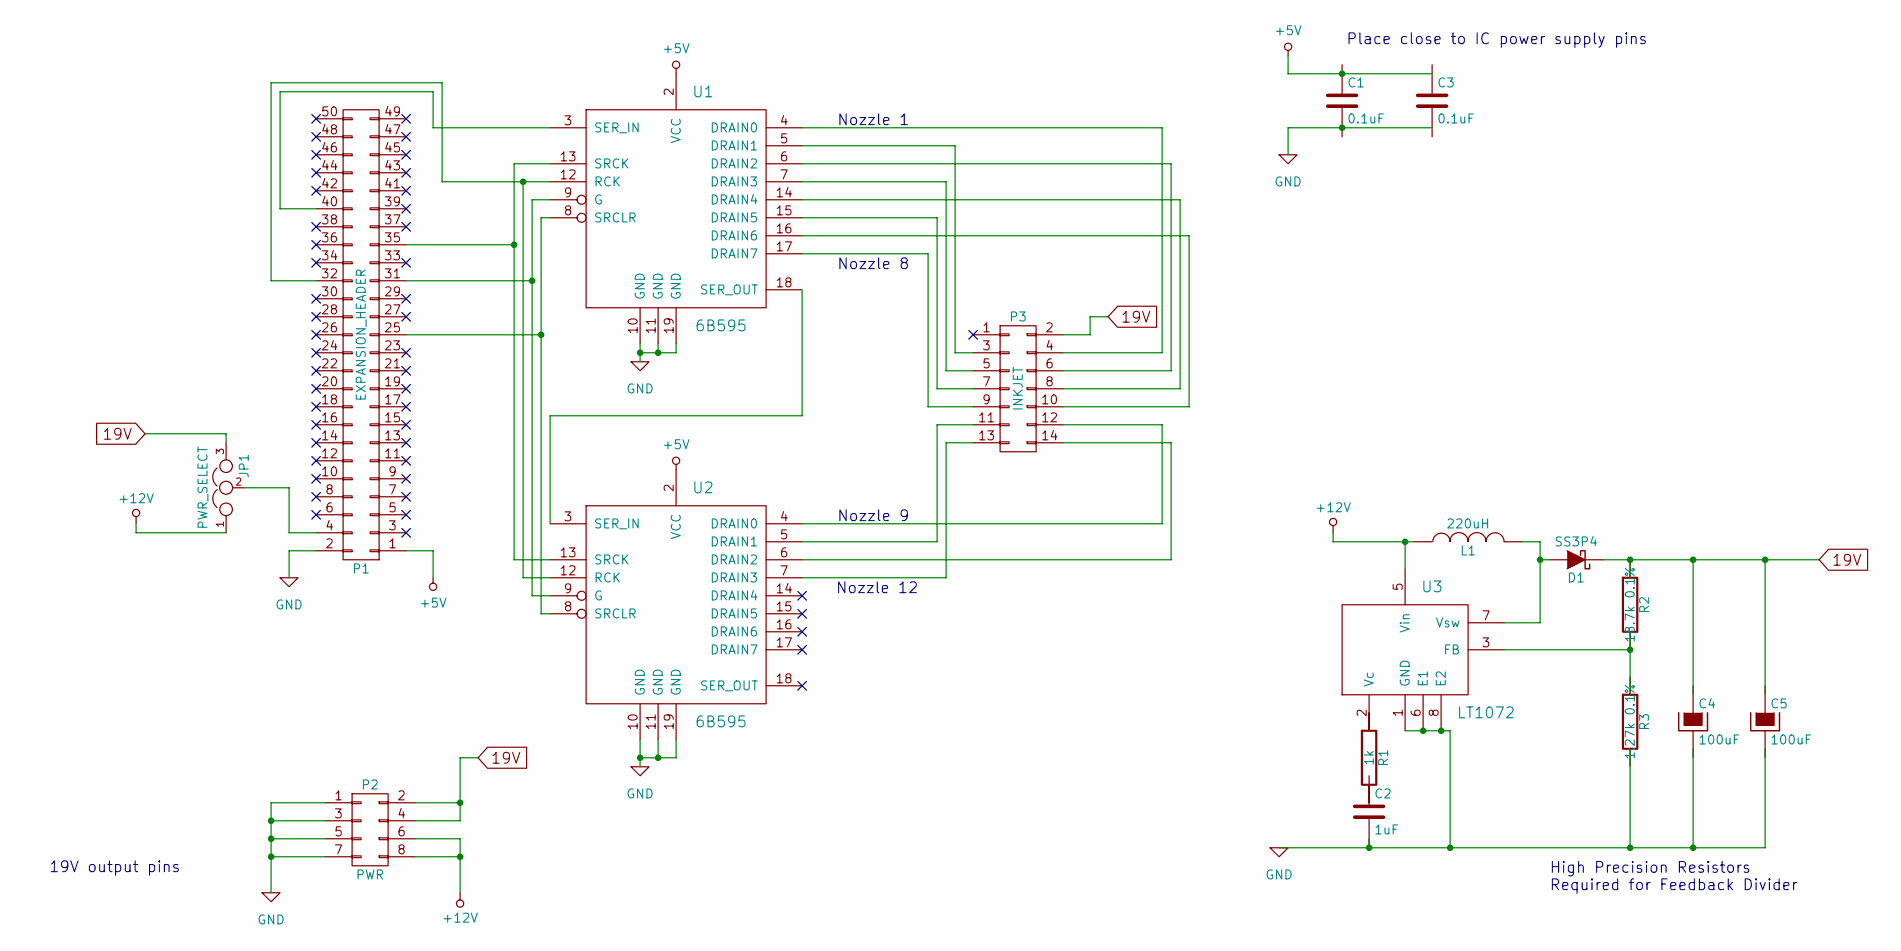
[picture p53: schematic InkjetDriver.sch, Inkjet Driver Circuit]

Parts:
C1, C3: 0.1uF; C_0603
C2: 1uF; C_0805
C4, C5: 100uF; c_elec_6.3x7.7
D1: SS3P4; DO-220_Diode
JP1: PWR_SELECT; Socket_Strip_Straight_1x03
L1: 220uH; CLF6045_Inductor
P1: EXPANSION_HEADER; Pin_Header_Straight_2x25
P2: PWR; Pin_Header_Straight_2x04_Silk_Change
P3: INKJET; Pin_Header_Straight_2x07
R1: 1k; R_0603
R2: 18.7k 0.1%; R_0603
R3: 1.27k 0.1%; R_0603
U1, U2: 6B595; SOIC-20_7.5x12.8mm_Pitch1.27mm
U3: LT1072; SOIC-8-N

Connections:
19V: C4.1, C5.1, D1.1 (K), JP1.3, P2.2, P2.4, P3.2, R2.1
+5V: C1.1, C3.1, P1.1, U1.2 (VCC), U2.2 (VCC)
+12V: JP1.1, L1.1, P2.6, P2.8, U3.5 (Vin)
GND: C1.2, C2.2, C3.2, C4.2, C5.2, P1.2, P2.1, P2.3, P2.5, P2.7, R3.2, U1.10 (GND), U1.11 (GND), U1.19 (GND), U2.10 (GND), U2.11 (GND), U2.19 (GND), U3.1 (GND), U3.6 (E1), U3.8 (E2); also elsewhere on the board
unnamed: C2.1, R1.2
unnamed: D1.2 (A), L1.2, U3.7 (Vsw)
unnamed: JP1.2, P1.4
unnamed: P1.25, U1.8 (SRCLR), U2.8 (SRCLR)
unnamed: P1.31, U1.9 (G), U2.9 (G)
unnamed: P1.32, U1.12 (RCK), U2.12 (RCK)
unnamed: P1.35, U1.13 (SRCK), U2.13 (SRCK)
unnamed: P1.40, U1.3 (SER_IN)
unnamed: P3.3, U1.5 (DRAIN1)
unnamed: P3.4, U1.4 (DRAIN0)
unnamed: P3.5, U1.7 (DRAIN3)
unnamed: P3.6, U1.6 (DRAIN2)
unnamed: P3.7, U1.15 (DRAIN5)
unnamed: P3.8, U1.14 (DRAIN4)
unnamed: P3.9, U1.17 (DRAIN7)
unnamed: P3.10, U1.16 (DRAIN6)
unnamed: P3.11, U2.5 (DRAIN1)
unnamed: P3.12, U2.4 (DRAIN0)
unnamed: P3.13, U2.7 (DRAIN3)
unnamed: P3.14, U2.6 (DRAIN2)
unnamed: R1.1, U3.2 (Vc)
unnamed: U1.18 (SER_OUT), U2.3 (SER_IN)

Notes on the sheet:
Nozzle 1
Nozzle 8
Nozzle 9
Nozzle 12
Place close to IC power supply pins
19V output pins
High Precision Resistors Required for Feedback Divider

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
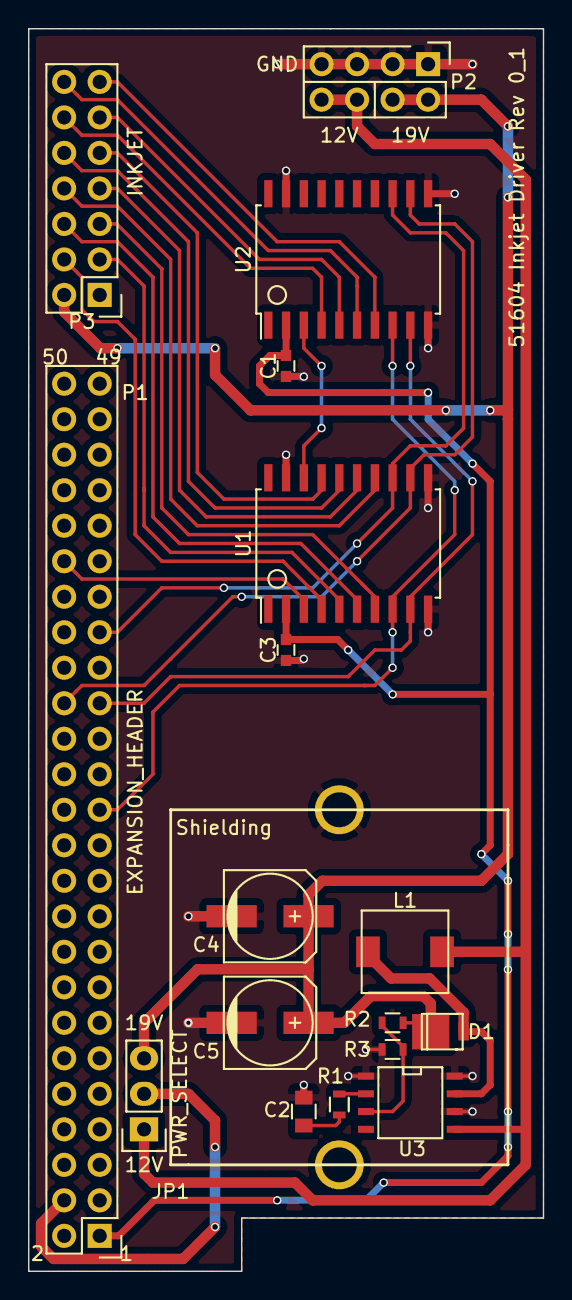
[picture p54: board InkjetDriver.kicad_pcb from above]

Board: 2 copper layers, 36.8 x 88.9 mm, 19 parts (0 on the bottom side), 27 nets.

Other parts of the board:
SM1: Shielding; SolderWirePad_single_2-5mmDrill
SM2: Shield; SolderWirePad_single_2-5mmDrill

Their connections:
GND: SM1.1, SM2.1; also elsewhere on the board
