danielprint/Inkjet/(commit log)

2013-12-24 First commit.
    [inkjet.dxf, insert.g, insert.scad, insert.stl]
2013-12-25 Better insert design.
    [insert.scad, insert.stl]
2014-09-24 Designs for HP51604A head added.
    [HP51604A.fcstd, just-slots.dxf, slots.dxf, test.dxf]
2014-11-24 Amberish's report added.
    [chans-outline.dxf, outline.dxf, slots.dxf]
2015-07-06 Oliver's designs added.
    [CableTidy.stl, HP51604A.fcstd, InkjetBreakout-F_Cu.dxf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]
2015-07-07 Step files for HP inkjet holder added, and photos of it.
    [InkjetBreakout-F_Cu.dxf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]
2015-07-09 Updating the Inkjet repository with all Oliver's files. There may be some duplicates that need to be sorted out.
    [CableTidy.ipt, CableTidy.stl, Inkjet.0006.ipt, Inkjet.ipt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]
2015-07-13 'Inkjet driver PCB files added'
    [CableTidy.ipt, CableTidy.stl, HP51604A.fcstd, Inkjet.0006.ipt, Inkjet.ipt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]
2015-07-13 Interface PCB changed to allow 19V supply to be routed past the buck converter.
    [InkjetDriver-B_Cu.gbr, InkjetDriver-B_Mask.gbr, InkjetDriver-B_SilkS.gbr, InkjetDriver-Edge_Cuts.gbr, InkjetDriver-F_Cu.gbr, InkjetDriver-F_Mask.gbr, InkjetDriver-F_SilkS.gbr, InkjetDriver.drl]
2015-07-13 Fixed (I think) the component numbers in the inkjet driver.
    [InkjetDriver.kicad_pcb, InkjetDriver.sch]
2015-07-14 Bill of materials added
    [BOM_mount+PCB.ods, InkjetDriver.sch, InkjetDriverBOM.csv, _saved_InkjetDriver.sch]
2015-07-20 Bringing files up to date
    [InkjetDriver-F_Cu.dxf]
2015-07-20 Screw-hole lugs added to horizontal mount.
    [CableTidy.stp, InkjetHolderHorizontalMount.stp, InkjetHolderVerticalMount.stl, InkjetHolderVerticalMount.stp, UpperHorizontalMount.fcstd, UpperHorizontalMount.stl, UpperHorizontalMount.stp, UpperVerticalMount.stl]
2015-07-20 Instructions and BOM added
    [BOM_mount+PCB.ods]
2015-07-20 Horizontal mount slot expanded to accommodate PCB.
    [InkjetHolderHorizontalMount.fcstd, InkjetHolderHorizontalMount.stl, InkjetHolderHorizontalMount.stp, UpperHorizontalMount.fcstd, UpperHorizontalMount.stl]
2015-09-04 Update on the day of Oliver's leaving - all his latest files.
    [BOM_mount+PCB.ods, Body.stl, Body.stp, BottomOrmerodMount.stl, BottomOrmerodMount.stp, CableTidy.stl, CableTidy.stp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]
2015-09-08 Added FreeCAD versions.
    [InkjetHolderHorizontalMount.fcstd, UpperHorizontalMount.fcstd, section.dxf]
2015-11-16 SVG solder mask added.
